CSutter5/MM8108-Dev-Kit/BOM.xlsx

Number of PCB's |  | 1
Reference | Qty per board | Total Qty | Value | Cost for Per | Cost | URL | Part Number
C3,C2,C4,C1 | 4 | 4 | 100.0nF | $0.01 | $0.03 | https://www.digikey.com/en/products/detail/samsung-electro-mechanics/CL10F104ZB8NNNC/3886670 | 1276-1012-1-ND
C6,C7,C5,C9 | 4 | 4 | 10.0uF | $0.03 | $0.10 | https://www.digikey.com/en/products/detail/samsung-electro-mechanics/CL10A106KP8NNNC/3886850 | 1276-1192-1-ND
C8 | 1 | 1 | 2.20uF | $0.08 | $0.08 | https://www.digikey.com/en/products/detail/samsung-electro-mechanics/CL10B225KP8NNNC/3886792 | 1276-1134-1-ND | Total Cost | $31.19
C11,C10 | 2 | 2 | 22.0pF | $0.04 | $0.07 | https://www.digikey.com/en/products/detail/samsung-electro-mechanics/CL10C220JB8NNNC/3886681 | 1276-1023-1-ND | Cost Per Board | $31.19
R3,R2,R1 | 3 | 3 | 330 | $0.01 | $0.02 | https://www.digikey.com/en/products/detail/yageo/RC0603FR-07330RL/727162 | 311-330HRCT-ND
R4,R5 | 2 | 2 | 5.10k | $0.01 | $0.01 | https://www.digikey.com/en/products/detail/yageo/RC0603FR-075K1L/727268 | 311-5.10KHRCT-ND
R6 | 1 | 1 | 220.0k | $0.01 | $0.01 | https://www.digikey.com/en/products/detail/stackpole-electronics-inc/RMCF0603FT220K/1760805 | RMCF0603FT220KCT-ND
R7,R9 | 2 | 2 | 100.0k | $0.01 | $0.01 | https://www.digikey.com/en/products/detail/stackpole-electronics-inc/RMCF0603FT100K/1761112 | RMCF0603FT100KCT-ND
R8 | 1 | 1 | 453.0k | $0.10 | $0.10 | https://www.digikey.com/en/products/detail/stackpole-electronics-inc/RMCF0603FT453K/1761122 | RMCF0603FT453KCT-ND
J1 | 1 | 1 | Conn_Coaxial | $1.50 | $1.50 | https://www.digikey.com/en/products/detail/sparkfun-electronics/23187/21679198 | 1568-23187-ND
J2 | 1 | 1 | USB_C_Receptacle | $0.74 | $0.74 | https://www.digikey.com/en/products/detail/gct/USB4105-GF-A/11198441 | 2073-USB4105-GF-ACT-ND
J4,J3 | 2 | 2 | Conn_02x05 | $0.00 | $0.00
J5 | 1 | 1 | Conn_02x04 | $0.00 | $0.00
SW1 | 1 | 1 | SW_SPST | $0.24 | $0.24 | https://www.digikey.com/en/products/detail/c-k/PTS636SK25FSMTR-LFS/10071743 | CKN12330-1-ND
D1,D3 | 2 | 2 | GREEN | 0.1 | $0.20 | https://www.digikey.com/en/products/detail/harvatek-corporation/B1911NG-20D000214U1930/15519989 | 3147-B1911NG--20D000214U1930CT-ND
D2 | 1 | 1 | RED | $0.10 | $0.10 | https://www.digikey.com/en/products/detail/harvatek-corporation/B1911USD-20D000114U1930/15519991 | 3147-B1911USD-20D000114U1930CT-ND
L1 | 1 | 1 | 2.20uH | $0.17 | $0.17 | https://www.digikey.com/en/products/detail/te-connectivity-passive-product/2-2176797-6/27792014 | 1712-2-2176797-6CT-ND
U1 | 1 | 1 | MM8108-MF15457 | $24.86 | $24.86 | https://www.mouser.com/ProductDetail/Morse-Micro/MM8108-MF15457?qs=4dK74SdgGtzPUa4%2FkXv9dA%3D%3D | 923-MM8108-MF15457
U2 | 1 | 1 | AP3401 | $0.27 | $0.27 | https://www.digikey.com/en/products/detail/diodes-incorporated/AP3401KTTR-G1/6186982 | AP3401KTTR-G1DICT-ND
PCB | 1 | 1 |  | $2.67 | $2.67
