CSutter5/MM8108-Dev-Kit/MM8108-Dev-Kit.kicad_pcb

## KiCad design MM8108-Dev-Kit.kicad_pcb (2026-02-19)

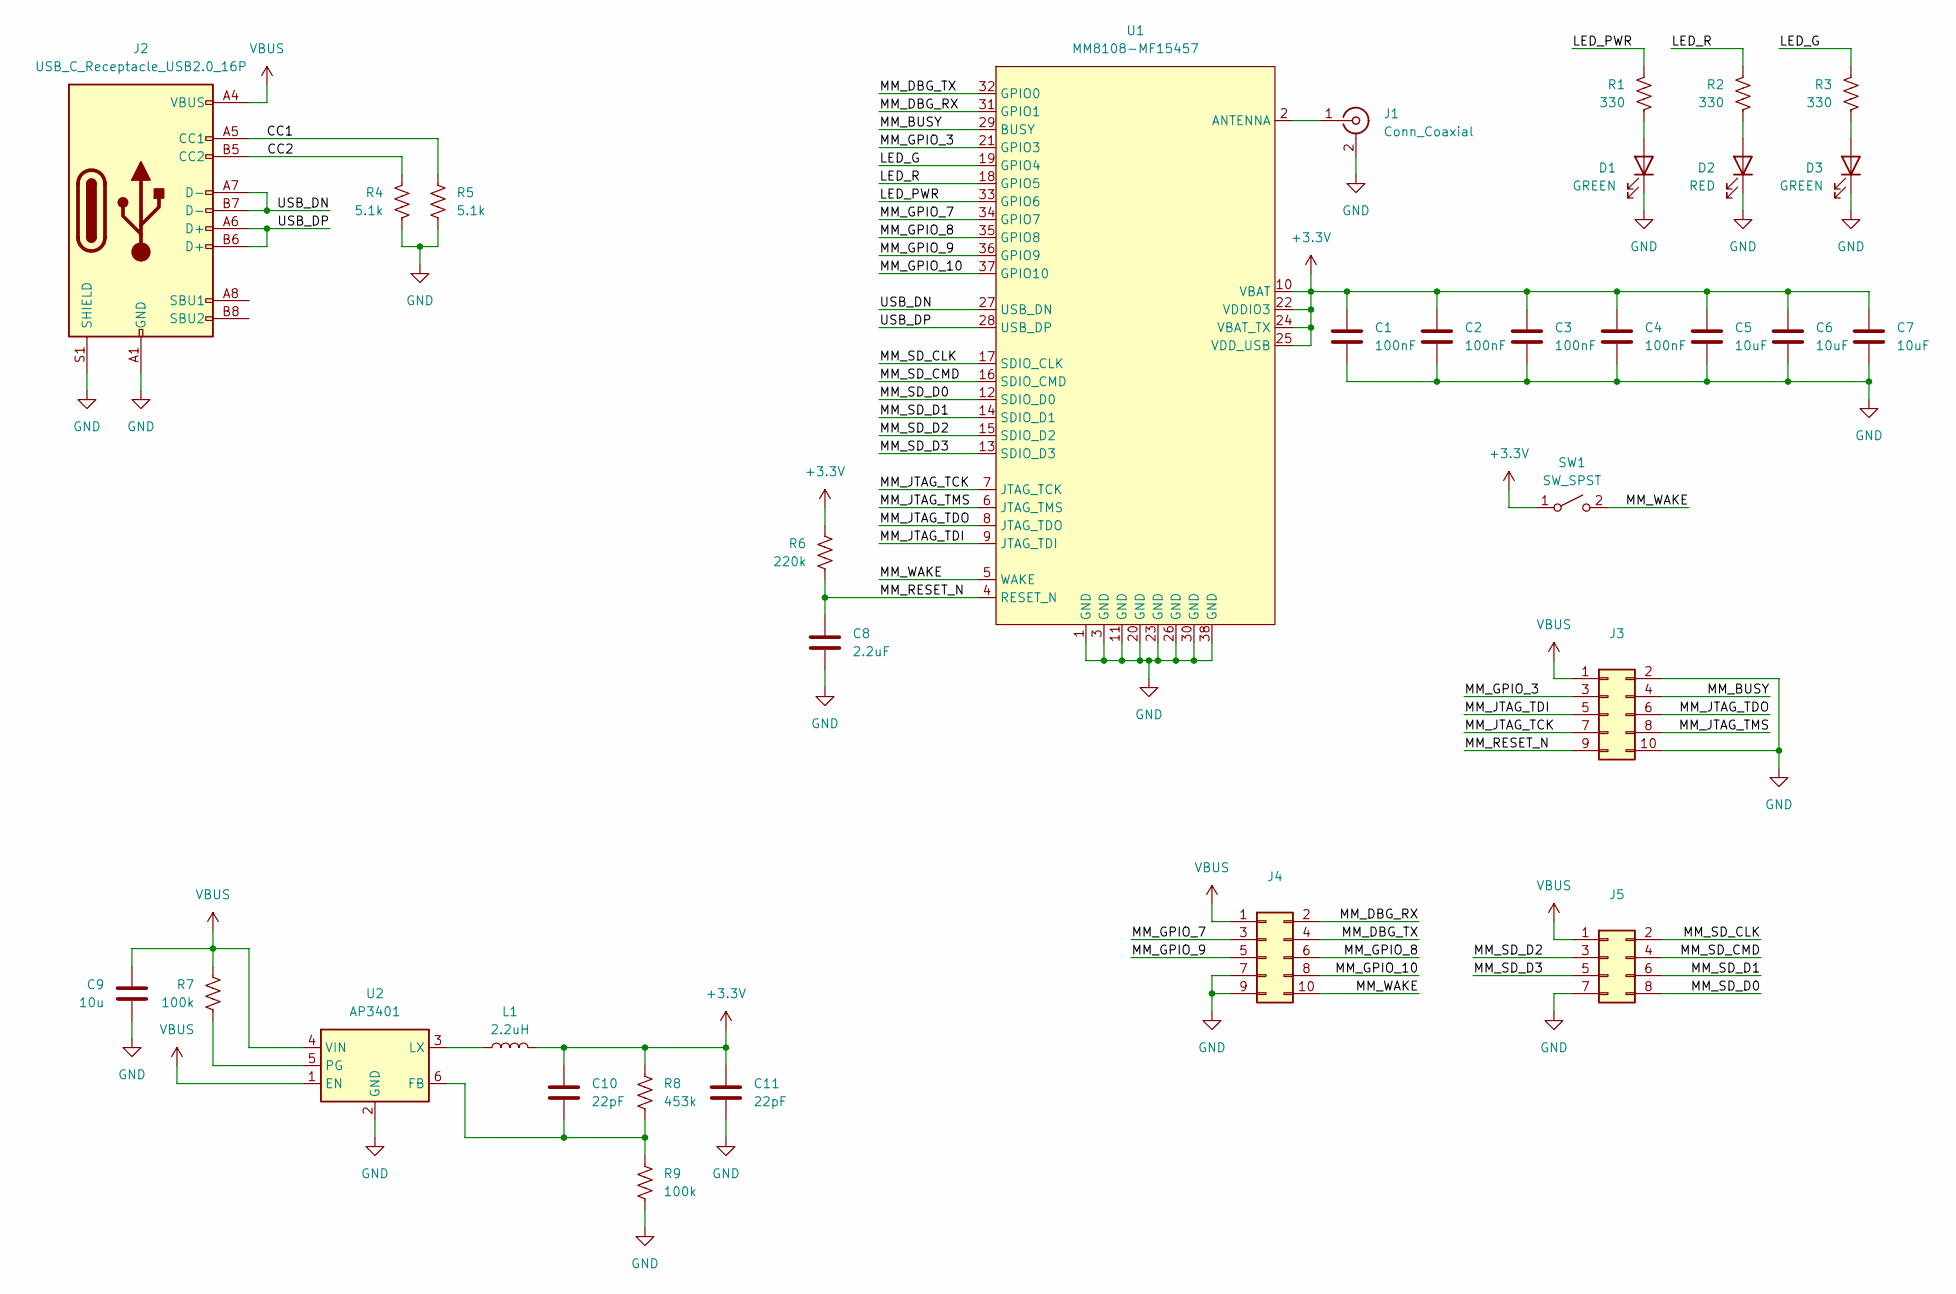
[picture p1: schematic MM8108-Dev-Kit.kicad_sch]

Parts:
C1, C2, C3, C4: 100nF; C_0603_1608Metric_Pad1.08x0.95mm_HandSolder
C5, C6, C7: 10uF; C_0603_1608Metric_Pad1.08x0.95mm_HandSolder
C8: 2.2uF; C_0603_1608Metric_Pad1.08x0.95mm_HandSolder
C9: 10u; C_0603_1608Metric_Pad1.08x0.95mm_HandSolder
C10, C11: 22pF; C_0603_1608Metric_Pad1.08x0.95mm_HandSolder
D1, D3: GREEN; D_0603_1608Metric_Pad1.05x0.95mm_HandSolder
D2: RED; D_0603_1608Metric_Pad1.05x0.95mm_HandSolder
J1: Conn_Coaxial; SMA_Samtec_SMA-J-P-H-ST-EM1_EdgeMount
J2: USB_C_Receptacle_USB2.0_16P; USB_C_Receptacle_GCT_USB4105-xx-A_16P_TopMnt_Horizontal
J3, J4: Conn_02x05_Odd_Even; PinSocket_2x05_P2.54mm_Vertical
J5: Conn_02x04_Odd_Even; PinHeader_2x04_P2.54mm_Vertical
L1: 2.2uH; L_0805_2012Metric_Pad1.05x1.20mm_HandSolder
R1, R2, R3: 330; R_0603_1608Metric_Pad0.98x0.95mm_HandSolder
R4, R5: 5.1k; R_0603_1608Metric_Pad0.98x0.95mm_HandSolder
R6: 220k; R_0603_1608Metric_Pad0.98x0.95mm_HandSolder
R7, R9: 100k; R_0603_1608Metric_Pad0.98x0.95mm_HandSolder
R8: 453k; R_0603_1608Metric_Pad0.98x0.95mm_HandSolder
SW1: SW_SPST; SW_Tactile_SPST_NO_Straight_CK_PTS636Sx25SMTRLFS
U1: MM8108-MF15457; MF15457
U2: AP3401; TSOT-23-6_HandSoldering

Connections:
+3.3V: C1.1, C2.1, C3.1, C4.1, C5.1, C6.1, C7.1, C10.1, C11.1, L1.2, R6.1, R8.1, SW1.1 (A), U1.10 (VBAT), U1.22 (VDDIO3), U1.24 (VBAT_TX), U1.25 (VDD_USB)
/CC1: J2.A5 (CC1), R5.1
/CC2: J2.B5 (CC2), R4.1
/LED_G: R3.1, U1.19 (GPIO4)
/LED_PWR: R1.1, U1.33 (GPIO6)
/LED_R: R2.1, U1.18 (GPIO5)
/MM_BUSY: J3.4, U1.29 (BUSY)
/MM_DBG_RX: J4.2, U1.31 (GPIO1)
/MM_DBG_TX: J4.4, U1.32 (GPIO0)
/MM_GPIO_3: J3.3, U1.21 (GPIO3)
/MM_GPIO_7: J4.3, U1.34 (GPIO7)
/MM_GPIO_8: J4.6, U1.35 (GPIO8)
/MM_GPIO_9: J4.5, U1.36 (GPIO9)
/MM_GPIO_10: J4.8, U1.37 (GPIO10)
/MM_JTAG_TCK: J3.7, U1.7 (JTAG_TCK)
/MM_JTAG_TDI: J3.5, U1.9 (JTAG_TDI)
/MM_JTAG_TDO: J3.6, U1.8 (JTAG_TDO)
/MM_JTAG_TMS: J3.8, U1.6 (JTAG_TMS)
/MM_RESET_N: C8.1, J3.9, R6.2, U1.4 (RESET_N)
/MM_SD_CLK: J5.2, U1.17 (SDIO_CLK)
/MM_SD_CMD: J5.4, U1.16 (SDIO_CMD)
/MM_SD_D0: J5.8, U1.12 (SDIO_D0)
/MM_SD_D1: J5.6, U1.14 (SDIO_D1)
/MM_SD_D2: J5.3, U1.15 (SDIO_D2)
/MM_SD_D3: J5.5, U1.13 (SDIO_D3)
/MM_WAKE: J4.10, SW1.2 (B), U1.5 (WAKE)
/USB_DN: J2.A7 (D-), J2.B7 (D-), U1.27 (USB_DN)
/USB_DP: J2.A6 (D+), J2.B6 (D+), U1.28 (USB_DP)
GND: C1.2, C2.2, C3.2, C4.2, C5.2, C6.2, C7.2, C8.2, C9.2, C11.2, D1.1 (K), D2.1 (K), D3.1 (K), J1.2 (Ext), J2.A1 (GND), J2.A12 (GND), J2.B1 (GND), J2.B12 (GND), J2.S1 (SHIELD), J3.2, J3.10, J4.7, J4.9, J5.7, R4.2, R5.2, R9.2, U1.1 (GND), U1.3 (GND), U1.11 (GND), U1.20 (GND), U1.23 (GND), U1.26 (GND), U1.30 (GND), U1.38 (GND), U2.2 (GND)
unnamed: D1.2 (A), R1.2
unnamed: D2.2 (A), R2.2
unnamed: D3.2 (A), R3.2
unnamed: J1.1 (In), U1.2 (ANTENNA)
unnamed: C10.2, R8.2, R9.1, U2.6 (FB)
unnamed: L1.1, U2.3 (LX)
unnamed: R7.2, U2.5 (PG)
VBUS: C9.1, J2.A4 (VBUS), J2.A9 (VBUS), J2.B4 (VBUS), J2.B9 (VBUS), J3.1, J4.1, J5.1, R7.1, U2.1 (EN), U2.4 (VIN)

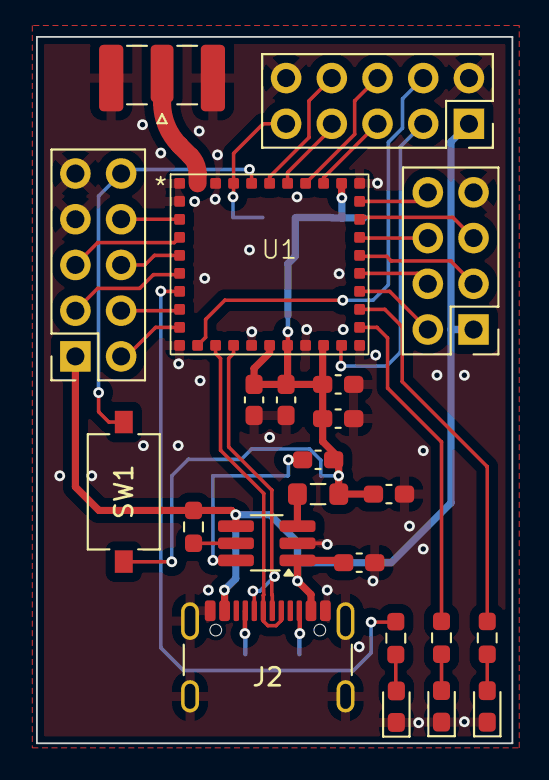
[picture p2: board MM8108-Dev-Kit.kicad_pcb from above]

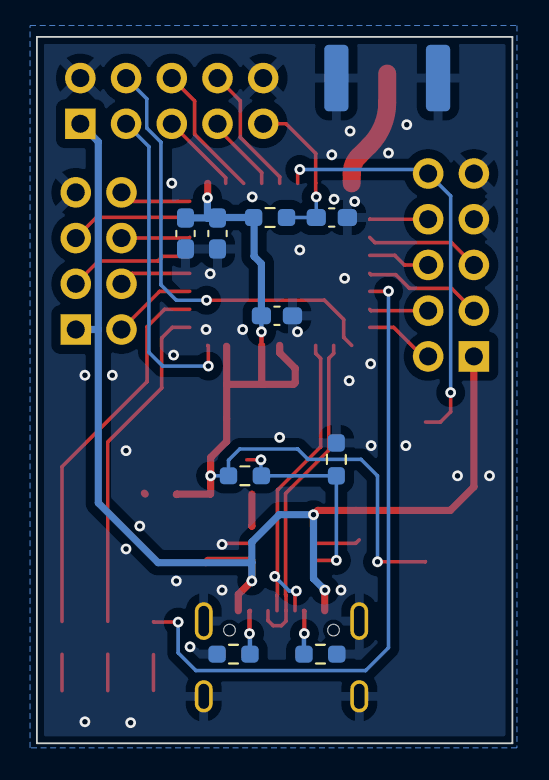
[picture p3: board MM8108-Dev-Kit.kicad_pcb from below]

Board: 2 copper layers, 26.4 x 39.2 mm, 32 parts (9 on the bottom side), 37 nets.
