CSutter5/MM8108-Dev-Kit/(commit log)

2026-02-19 Uploaded basic KiCad design
    [BOM.xlsx, MM8108-MF15457 dev kit.kicad_pcb, MM8108-MF15457 dev kit.kicad_sch]
2026-02-19 Renamed KiCad project files
    [MM8108-Dev-Kit.kicad_pcb, MM8108-Dev-Kit.kicad_sch]
